plugz/kp_ledsuit/kp_ledsuit.kicad_pcb

## KiCad design kp_ledsuit.kicad_pcb (2026-02-15)

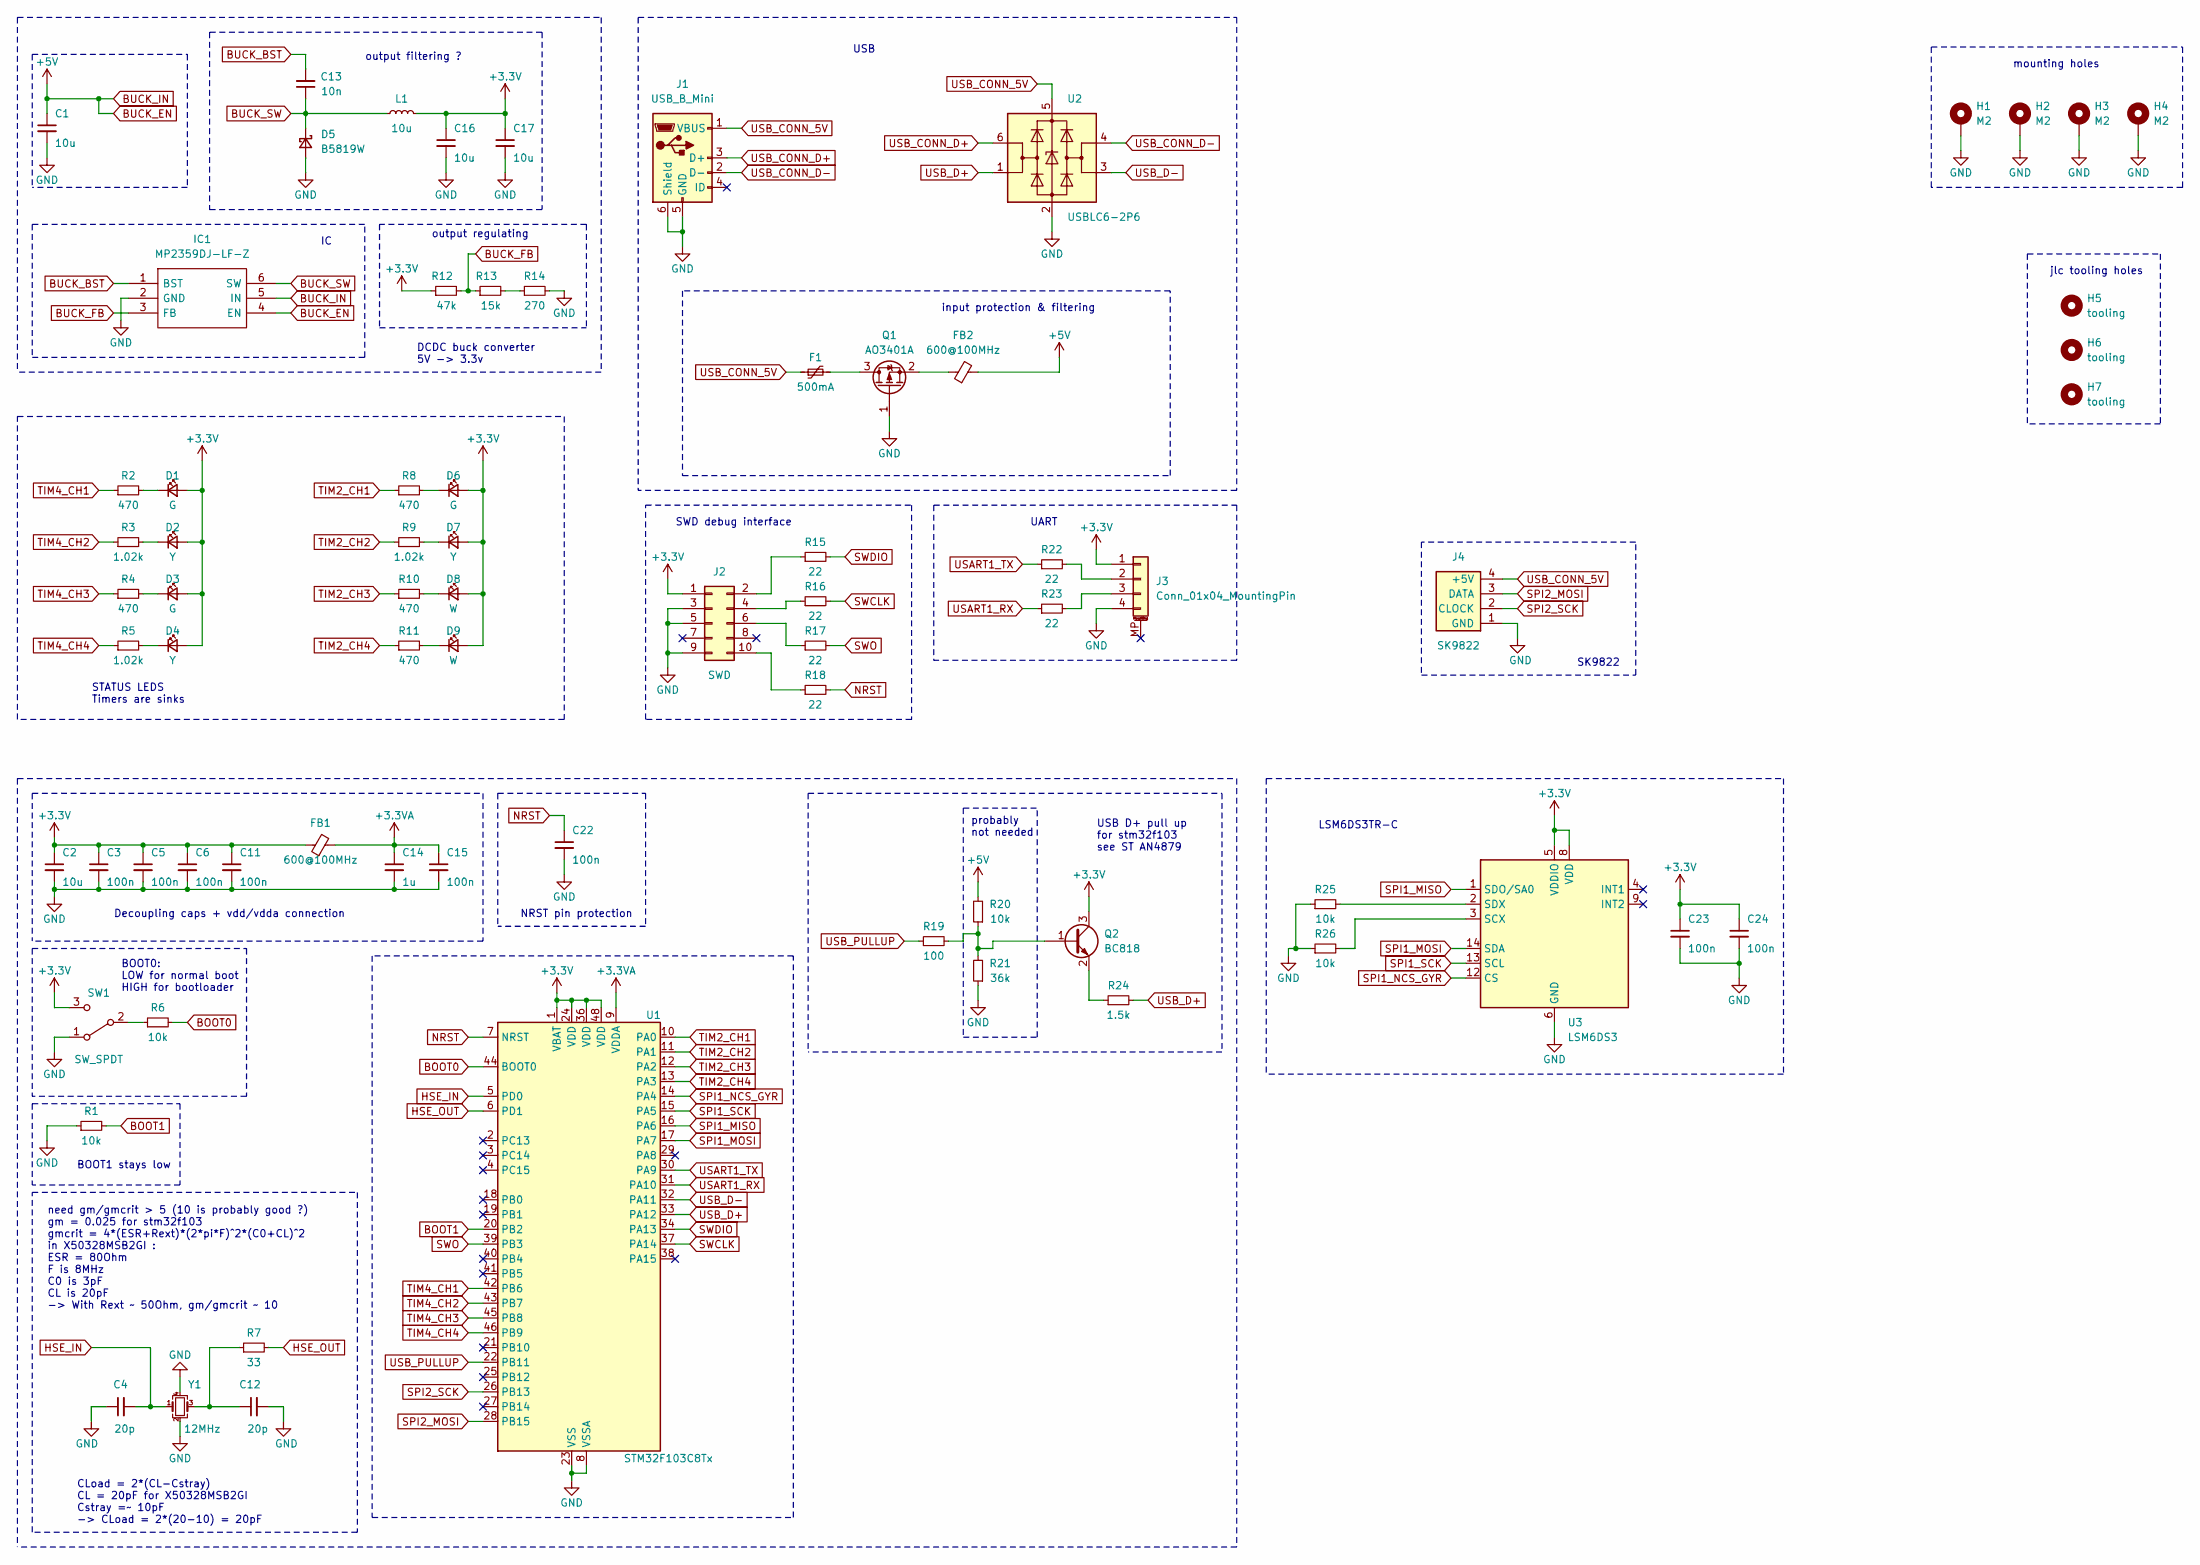
[picture p1: schematic kp_ledsuit.kicad_sch]

Parts:
C1, C2, C16, C17: 10u; C_1206_3216Metric; JLCPCB Part # C13585
C3, C5, C6, C11, C15, C22, C23, C24: 100n; C_0402_1005Metric; JLCPCB Part # C307331
C4, C12: 20p; C_0402_1005Metric; JLCPCB Part # C1554
C13: 10n; C_0603_1608Metric; JLCPCB Part # C57112
C14: 1u; C_0805_2012Metric; JLCPCB Part # C28323
D1, D3, D6: G; LED_0805_2012Metric; JLCPCB Part # C2297
D2, D4, D7: Y; LED_0805_2012Metric; JLCPCB Part # C2296
D5: B5819W; D_SOD-123; JLCPCB Part # C8598
D8, D9: W; LED_0805_2012Metric; JLCPCB Part # C34499
F1: 500mA; Fuse_1206_3216Metric; JLCPCB Part # C2984676
FB1, FB2: 600@100MHz; L_0805_2012Metric; JLCPCB Part # C1017
H1, H2, H3, H4: M2; MountingHole_2.2mm_M2_Pad_Via
H5, H6, H7: tooling; jlc_tooling_hole
IC1: MP2359DJ-LF-Z; SOT95P280X100-6N; Manufacturer_Part_Number MP2359DJ-LF-Z; Mouser Part Number 946-MP2359DJLFZ
J1: USB_B_Mini; USB_Mini-B_Wuerth_65100516121_Horizontal
J2: SWD; PinSocket_2x05_P1.27mm_Vertical_SMD
J3: Conn_01x04_MountingPin; Molex_PicoBlade_53261-0471_1x04-1MP_P1.25mm_Horizontal
J4: SK9822; SK9822_edge_solder
L1: 10u; L_Sunlord_MWSA0503S; JLCPCB Part # C408412
Q1: AO3401A; SOT-23; JLCPCB Part # C15127
Q2: BC818; SOT-23; JLCPCB Part # C154797
R1, R6, R25, R26: 10k; R_0603_1608Metric; JLCPCB Part # C25804
R2, R4, R8, R10, R11: 470; R_0805_2012Metric; JLCPCB Part # C17710
R3, R5, R9: 1.02k; R_0805_2012Metric; JLCPCB Part # C17369
R7: 33; R_0402_1005Metric; JLCPCB Part # C25105
R12: 47k; R_1206_3216Metric
R13: 15k; R_1206_3216Metric
R14: 270; R_1206_3216Metric
R15, R16, R17, R18, R22, R23: 22; R_0402_1005Metric; JLCPCB Part # C25092
R19: 100; R_0603_1608Metric; JLCPCB Part # C22775
R20: 10k; R_0603_1608Metric
R21: 36k; R_0603_1608Metric
R24: 1.5k; R_0603_1608Metric; JLCPCB Part # C22843
SW1: SW_SPDT; SW_SPDT_PCM12
U1: STM32F103C8Tx; LQFP-48_7x7mm_P0.5mm; JLCPCB Part # C8734
U2: USBLC6-2P6; SOT-666; JLCPCB Part # C15999
U3: LSM6DS3; LGA-14_3x2.5mm_P0.5mm_LayoutBorder3x4y; JLCPCB Part # C967633
Y1: 12MHz; Crystal_SMD_3225-4Pin_3.2x2.5mm; JLCPCB Part # C9002

Connections:
+3.3V: C2.1, C3.1, C5.1, C6.1, C11.1, C16.1, C17.1, C23.1, C24.1, D1.2 (A), D2.2 (A), D3.2 (A), D4.2 (A), D6.2 (A), D7.2 (A), D8.2 (A), D9.2 (A), FB1.1, J2.1, J3.1, L1.2, Q2.3 (C), R12.1, SW1.3 (C), U1.1 (VBAT), U1.24 (VDD), U1.36 (VDD), U1.48 (VDD), U3.5 (VDDIO), U3.8 (VDD)
+3.3VA: C14.1, C15.1, FB1.2, U1.9 (VDDA)
BOOT0: R6.2, U1.44 (BOOT0)
BOOT1: R1.2, U1.20 (PB2)
BUCK_BST: C13.2, IC1.1 (BST)
BUCK_EN: C1.1, FB2.2, IC1.4 (EN), IC1.5 (IN), R20.2
BUCK_FB: IC1.3 (FB), R12.2, R13.1
BUCK_SW: C13.1, D5.1 (K), IC1.6 (SW), L1.1
GND: C1.2, C2.2, C3.2, C4.1, C5.2, C6.2, C11.2, C12.2, C14.2, C15.2, C16.2, C17.2, C22.2, C23.2, C24.2, D5.2 (A), H1.1, H2.1, H3.1, H4.1, IC1.2 (GND), J1.5 (GND), J1.6 (Shield), J2.3, J2.5, J2.9, J3.4, J4.1 (GND), Q1.1 (G), R1.1, R14.2, R21.1, R25.1, R26.1, SW1.1 (A), U1.8 (VSSA), U1.23 (VSS), U1.35 (VSS), U1.47 (VSS), U2.2 (GND), U3.6 (GND), U3.7 (GND), Y1.2, Y1.4
HSE_IN: C4.2, U1.5 (PD0), Y1.1
HSE_OUT: R7.2, U1.6 (PD1)
NRST: C22.1, R18.2, U1.7 (NRST)
unnamed: C12.1, R7.1, Y1.3
unnamed: D1.1 (K), R2.2
unnamed: D2.1 (K), R3.2
unnamed: D3.1 (K), R4.2
unnamed: D4.1 (K), R5.2
unnamed: D6.1 (K), R8.2
unnamed: D7.1 (K), R9.2
unnamed: D8.1 (K), R10.2
unnamed: D9.1 (K), R11.2
unnamed: J2.2, R15.1
unnamed: J2.4, R16.1
unnamed: J2.6, R17.1
unnamed: J2.10, R18.1
unnamed: J3.2, R22.2
unnamed: J3.3, R23.2
unnamed: F1.2, Q1.3 (D)
unnamed: FB2.1, Q1.2 (S)
unnamed: Q2.1 (B), R19.2, R20.1, R21.2
unnamed: Q2.2 (E), R24.1
unnamed: R13.2, R14.1
unnamed: R6.1, SW1.2 (B)
unnamed: R26.2, U3.3 (SCX)
unnamed: R25.2, U3.2 (SDX)
SPI1_MISO: U1.16 (PA6), U3.1 (SDO/SA0)
SPI1_MOSI: U1.17 (PA7), U3.14 (SDA)
SPI1_NCS_GYR: U1.14 (PA4), U3.12 (CS)
SPI1_SCK: U1.15 (PA5), U3.13 (SCL)
SPI2_MOSI: J4.3 (DATA), U1.28 (PB15)
SPI2_SCK: J4.2 (CLOCK), U1.26 (PB13)
SWCLK: R16.2, U1.37 (PA14)
SWDIO: R15.2, U1.34 (PA13)
SWO: R17.2, U1.39 (PB3)
TIM2_CH1: R8.1, U1.10 (PA0)
TIM2_CH2: R9.1, U1.11 (PA1)
TIM2_CH3: R10.1, U1.12 (PA2)
TIM2_CH4: R11.1, U1.13 (PA3)
TIM4_CH1: R2.1, U1.42 (PB6)
TIM4_CH2: R3.1, U1.43 (PB7)
TIM4_CH3: R4.1, U1.45 (PB8)
TIM4_CH4: R5.1, U1.46 (PB9)
USART1_RX: R23.1, U1.31 (PA10)
USART1_TX: R22.1, U1.30 (PA9)
USB_CONN_5V: F1.1, J1.1 (VBUS), J4.4 (+5V), U2.5 (VBUS)
USB_CONN_D+: J1.3 (D+), U2.6 (I/O1)
USB_CONN_D-: J1.2 (D-), U2.4 (I/O2)
USB_D+: R24.2, U1.33 (PA12), U2.1 (I/O1)
USB_D-: U1.32 (PA11), U2.3 (I/O2)
USB_PULLUP: R19.1, U1.22 (PB11)

Notes on the sheet:
USB
UART
output filtering ?
LSM6DS3TR-C
USB D+ pull up for stm32f103 see ST AN4879
STATUS LEDS Timers are sinks
DCDC buck converter 5V -> 3.3v
input protection & filtering
BOOT1 stays low
jlc tooling holes
output regulating
need gm/gmcrit > 5 (10 is probably good ?) gm = 0.025 for stm32f103 gmcrit = 4*(ESR+Rext)*(2*pi*F)^2*(C0+CL)^2 in X50328MSB2GI : ESR = 80Ohm F is 8MHz C0 is 3pF CL is 20pF -> With Rext ~ 50Ohm, gm/gmcrit ~ 10
CLoad = 2*(CL-Cstray) CL = 20pF for X50328MSB2GI Cstray =~ 10pF -> CLoad = 2*(20-10) = 20pF
NRST pin protection
Decoupling caps + vdd/vdda connection
SK9822
probably not needed
BOOT0: LOW for normal boot HIGH for bootloader
SWD debug interface
mounting holes

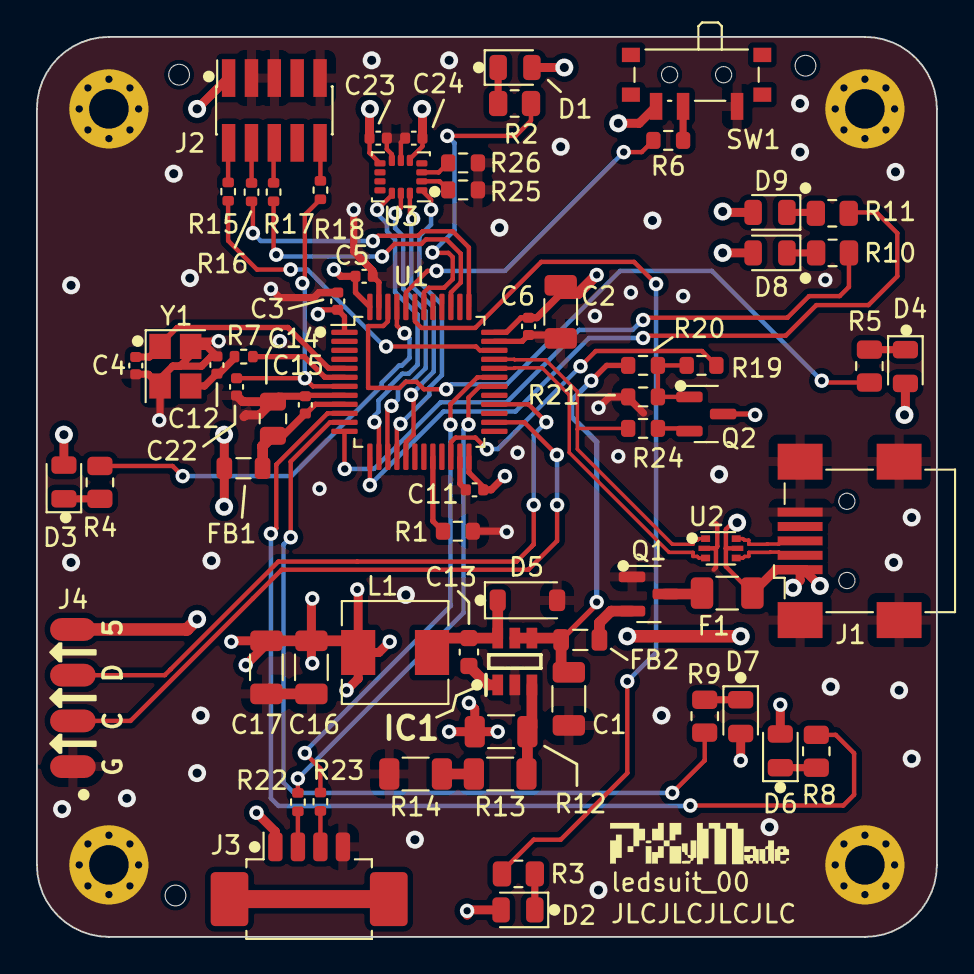
[picture p2: board kp_ledsuit.kicad_pcb from above]

Board: 4 copper layers, 50.0 x 50.0 mm, 74 parts (0 on the bottom side), 60 nets.
