plugz/kp_ledsuit/(commit log)

2024-02-05 add empty kicad project
    [kp_ledsuit.kicad_pcb, kp_ledsuit.kicad_sch]
2024-02-22 add stm32
    [kp_ledsuit.kicad_sch]
2024-02-22 add power, usb, swd, onboard leds
    [kp_ledsuit.kicad_sch]
2024-02-24 add IMU & SKconn + move input protections to USB part
    [kp_ledsuit.kicad_sch]
2024-02-24 begin layout
    [kp_ledsuit.kicad_pcb, kp_ledsuit.kicad_sch]
2024-02-26 WIP first proto layout: 1 face
    [kp_ledsuit.kicad_pcb, kp_ledsuit.kicad_sch]
2024-02-26 pxm test logo
    [kp_ledsuit.kicad_pcb]
2024-03-02 v00 - send to prod
    [kp_ledsuit.kicad_pcb, kp_ledsuit.kicad_sch]
2026-02-15 update to kicad9
    [kp_ledsuit.kicad_pcb, kp_ledsuit.kicad_sch]
2026-08-15 kicad version migrate
2026-11-06 cubemx : slow SPI down
2026-11-06 cubemx: enable spi dma for leds
